magnotrans/sd2snes/README.md

sd2snes
=======

SD card based multi-purpose cartridge for the SNES
