magnotrans/sd2snes/pcb/kicad/RevF/sd2snes.kicad_pcb

## KiCad design pcb/kicad/RevF/sd2snes.kicad_pcb (2018-08-11)

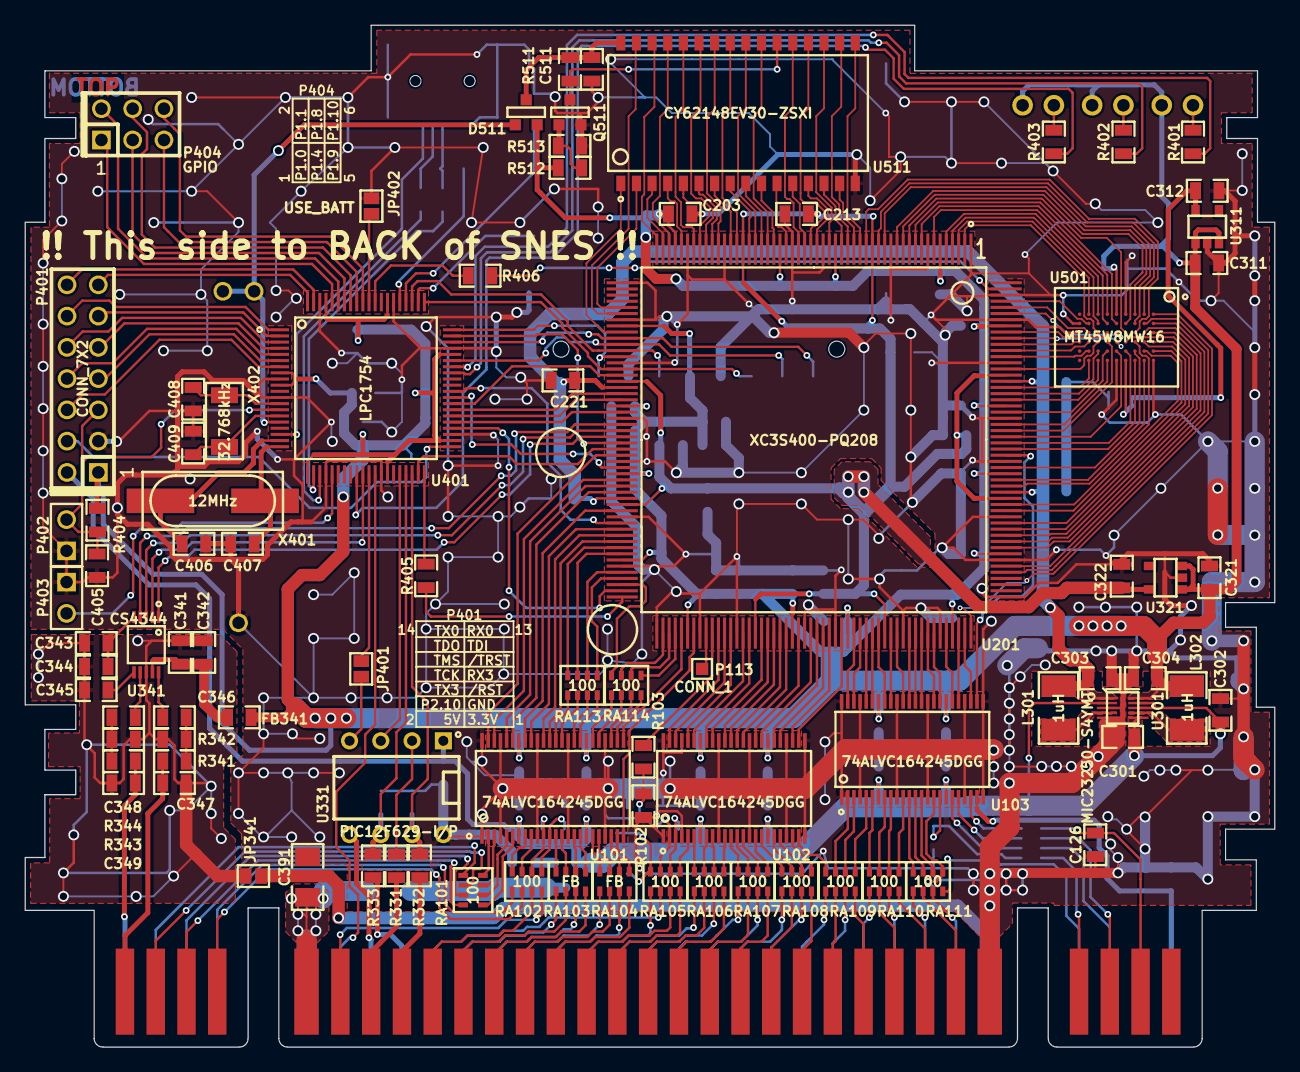
[picture p1: board sd2snes.kicad_pcb from above]

Board: 2 copper layers, 101.5 x 83.0 mm, 153 parts (0 on the bottom side), 326 nets.

Parts:
BT351: Keystone 1059 / KZH20PCB; BT_KEYSTONE_1059_20MM
C101, C102, C103, C104, C105, C106, C111, C112, C113, C114, C115, C116, C201, C202, C203, C204, C205, C206, C207, C208, C209, C210, C211, C212, C213, C214, C215, C221, C222, C223, C224, C231, C232, C233, C234, C331, C341, C343, C401, C402, C403, C404, C405, C412, C501, C502, C511: 100n; SM0805_FIXEDMASK
C121, C122, C123, C124, C125, C126, C127, C128, C408, C409: 10p; SM0805_FIXEDMASK
C301, C303, C304, C311, C312, C321, C322: 4.7u; SM0805_FIXEDMASK
C302, C347, C349: 10n; SM0805_FIXEDMASK
C332, C333: 100p; SM0805_FIXEDMASK
C342: 1u; SM0805_FIXEDMASK
C344, C345, C411: 10u; SM0805_FIXEDMASK
C346, C348: 3.3u; SM0805_FIXEDMASK
C391: 100u; SM1206_NEW
C406, C407: 33p; SM0805_FIXEDMASK
D401: LED 2mA 1.9V, green; LED-3MM-FIXED
D402: LED 2mA 1.8V, yellow; LED-3MM-FIXED
D403: LED 2mA 1.7V, red; LED-3MM-FIXED
D511: BAT54C; SOT23EBC
FB341: FILTER; SM0805_FIXEDMASK
J101: SNESCART_EXT; SNESCART_EXT2_SMTUSB
J411: Hirose DM1AA; HRS-DM1AA
J421: USB Mini-B SMT; USB_MINIB_SMT
JP341: FB 0603; GS2
JP401, JP402: JUMPER; GS2
L301, L302: 1uH; SM1210L_NEW
L391: 10uH; SM1210L_NEW
P113: CONN_1; PAD_1x1mm
P401: CONN_7X2; pin_array_7x2
P402, P403: CONN_2; PIN_ARRAY_2X1
P404: CONN_3X2; pin_array_3x2
Q101, Q511: 2N2222A; SOT23EBC
Q301: IRLML6402PbF; SOT23GDS
R101: 270; SM0805_FIXEDMASK
R102, R513: 100k; SM0805_FIXEDMASK
R103, R512: 4k7; SM0805_FIXEDMASK
R301, R511: 20k; SM0805_FIXEDMASK
R331, R332, R333, R401, R402, R403: 680; SM0805_FIXEDMASK
R341, R343: 470; SM0805_FIXEDMASK
R342, R344, R404, R407: 10k; SM0805_FIXEDMASK
R405, R406: 100; SM0805_FIXEDMASK
R421, R422: 33; SM0805_FIXEDMASK
R423: 1.5k; SM0805_FIXEDMASK
RA101, RA102, RA105, RA106, RA107, RA108, RA109, RA110, RA111, RA112, RA113, RA114: 100; R_PACK_1206_2
RA103, RA104: FB; R_PACK_1206_2
U101, U102, U103: 74ALVC164245DGG; TSSOP48
U201: XC3S400-PQ208; PQFP208
U301: MIC23250-S4YMT; QFN10-2x2_LONGPADS
U311: MCP1824-1802E/OT; SOT23-5_LARGEPADS
U321: MCP1824-2502E/OT; SOT23-5_LARGEPADS
U331: PIC12F629-I/P; DIP-8__300
U341: CS4344; TSSOP10
U401: LPC1754; LQFP80-.5
U501: MT45W8MW16; VFBGA54
U511: CY62148EV30-ZSXI; TSOPII-32
X401: 12MHz; HC49US
X402: 32.768kHz; XTAL_SMD_05019

Connections:
+1.2V: C221.1, C222.1, C223.1, C224.1, C303.1, L301.1, U201.70, U201.88, U201.174, U201.192, U301.1
+1.8V: C312.1, C502.1, U311.5, U501.D6
+2.5V: C210.1, C211.1, C212.1, C213.1, C214.1, C215.1, C322.1, U201.17, U201.38, U201.69, U201.89, U201.121, U201.142, U201.173, U201.193, U321.5
+3.3V: C101.1, C102.1, C103.1, C104.1, C105.1, C106.1, C201.1, C202.1, C203.1, C204.1, C205.1, C206.1, C207.1, C208.1, C209.1, C231.1, C232.1, C233.1, C234.1, C304.1, C311.1, C321.1, C401.1, C402.1, C403.1, C404.1, C411.1, C412.1, C501.1, D401.1, D402.1, D403.1, D511.1, FB341.1, J411.4, L302.2, P401.1, R404.2, R407.2, R512.2, U101.31, U101.42, U102.31, U102.42, U103.31, U103.42, U201.6, U201.23, U201.32, U201.49, U201.60, U201.73, U201.84, U201.98, U201.110, U201.127, U201.136, U201.153, U201.164, U201.177, U201.188, U201.201, U301.10, U311.1, U311.3, U321.1, U321.3, U401.8, U401.10, U401.21, U401.34, U401.42, U401.56, U401.67, U401.77, U501.E1
+3.3VDAC: C341.1, C342.1, FB341.2, U341.9
+5V: C111.1, C112.1, C113.1, C114.1, C115.1, C116.1, C301.1, C302.1, C331.1, P401.2, Q301.S, U101.7, U101.18, U102.7, U102.18, U103.7, U103.18, U301.2, U301.6, U301.8, U301.9, U331.1
+5VL: C391.1, J101.27, J101.58, L391.1
+BATT: BT351.1, D511.2, U401.16
/Memory/RAM_/CE: Q511.3, R511.2, U511.22
/Memory/SRAM_Vcc: C511.1, D511.3, R511.1, U511.32
/Power Supply / Misc./REG_SW1: L301.2, U301.4
/Power Supply / Misc./REG_SW2: L302.1, U301.7
/RESET: C405.1, P401.5, P402.2, R404.1, U401.14
/SNES Slot/SNES_EXT_/IRQ: J101.18, RA105.1
/SNES Slot/SNES_EXT_/PARD: J101.4, RA111.4
/SNES Slot/SNES_EXT_/PAWR: J101.35, RA112.8
/SNES Slot/SNES_EXT_/RD: J101.23, RA105.2
/SNES Slot/SNES_EXT_/ROMSEL: J101.49, RA105.3
/SNES Slot/SNES_EXT_/WR: J101.54, RA102.3
/SNES Slot/SNES_EXT_A0: J101.17, RA106.1
/SNES Slot/SNES_EXT_A1: J101.16, RA106.3
/SNES Slot/SNES_EXT_A2: J101.15, RA107.1
/SNES Slot/SNES_EXT_A3: J101.14, RA107.3
/SNES Slot/SNES_EXT_A4: J101.13, RA108.1
/SNES Slot/SNES_EXT_A5: J101.12, RA108.3
/SNES Slot/SNES_EXT_A6: J101.11, RA109.1
/SNES Slot/SNES_EXT_A7: J101.10, RA109.3
/SNES Slot/SNES_EXT_A8: J101.9, RA110.1
/SNES Slot/SNES_EXT_A9: J101.8, RA110.3
/SNES Slot/SNES_EXT_A10: J101.7, RA111.1
/SNES Slot/SNES_EXT_A11: J101.6, RA111.3
/SNES Slot/SNES_EXT_A12: J101.37, RA111.2
/SNES Slot/SNES_EXT_A13: J101.38, RA110.4
/SNES Slot/SNES_EXT_A14: J101.39, RA110.2
/SNES Slot/SNES_EXT_A15: J101.40, RA109.4
/SNES Slot/SNES_EXT_A16: J101.41, RA109.2
/SNES Slot/SNES_EXT_A17: J101.42, RA108.4
/SNES Slot/SNES_EXT_A18: J101.43, RA108.2
/SNES Slot/SNES_EXT_A19: J101.44, RA107.4
/SNES Slot/SNES_EXT_A20: J101.45, RA107.2
/SNES Slot/SNES_EXT_A21: J101.46, RA106.4
/SNES Slot/SNES_EXT_A22: J101.47, RA106.2
/SNES Slot/SNES_EXT_A23: J101.48, RA105.4
/SNES Slot/SNES_EXT_CPU_CLK: J101.57, RA102.4
/SNES Slot/SNES_EXT_D0: J101.19, RA104.3
/SNES Slot/SNES_EXT_D1: J101.20, RA104.1
/SNES Slot/SNES_EXT_D2: J101.21, RA103.3
/SNES Slot/SNES_EXT_D3: J101.22, RA103.1
/SNES Slot/SNES_EXT_D4: J101.50, RA104.4
/SNES Slot/SNES_EXT_D5: J101.51, RA104.2
/SNES Slot/SNES_EXT_D6: J101.52, RA103.4
/SNES Slot/SNES_EXT_D7: J101.53, RA103.2
/SNES Slot/SNES_EXT_PA0: J101.28, RA102.1
/SNES Slot/SNES_EXT_PA1: J101.59, RA102.2
/SNES Slot/SNES_EXT_PA2: J101.29, RA101.3
/SNES Slot/SNES_EXT_PA3: J101.60, RA101.4
/SNES Slot/SNES_EXT_PA4: J101.30, RA101.1
/SNES Slot/SNES_EXT_PA5: J101.61, RA101.2
/SNES Slot/SNES_EXT_PA6: J101.3, RA112.7
/SNES Slot/SNES_EXT_PA7: J101.34, RA112.6
/SNES Slot/SNES_EXT_REFRESH: C126.1, J101.33, RA112.5
/SNES Slot/SNES_EXT_SYS_CLK: J101.1, R101.2, U103.23
/TRST: P401.9, U401.4
/USEBATT: JP402.2, U401.70
AGND: C341.2, C342.2, C343.2, C344.2, C345.2, C347.2, C349.2, JP341.2, R342.2, R344.2, U341.8
AUDIO_L: C349.1, J101.31, R343.1
AUDIO_R: C347.1, J101.62, R341.1
CCLK: R405.1, U201.104
CIC_CLK: J101.56, R331.2
CIC_DATA0: C332.1, R332.1, U331.7, U401.38
CIC_DATA1: C333.1, R333.2, U331.6, U401.37
CIC_MCLR: JP401.2, U331.4
CIC_RESET: J101.25, U331.5
CIC_STATUS: U331.3, U401.36
DAC_/DEM: U341.2, U401.30
DAC_LRCK: U201.77, U341.3
DAC_MCLK: U201.76, U341.4
DAC_SDIN: U201.78, U341.1
DATABUS_/OE: U101.25, U201.109
DATABUS_DIR: U101.24, U201.111
DIN+MCU_/OVR: U201.92, U401.50
DONE: U201.103, U401.44
EXT_CIC_DATA0: J101.55, R332.2
EXT_CIC_DATA1: J101.24, R333.1
EXT_TDI: P401.11, U401.2
EXT_TDO: P401.12, U401.1
FPGA_CLK: U201.80, U401.39
GND: BT351.2, C101.2, C102.2, C103.2, C104.2, C105.2, C106.2, C111.2, C112.2, C113.2, C114.2, C115.2, C116.2, C121.2, C122.2, C123.2, C124.2, C125.2, C126.2, C127.2, C128.2, C201.2, C202.2, C203.2, C204.2, C205.2, C206.2, C207.2, C208.2, C209.2, C210.2, C211.2, C212.2, C213.2, C214.2, C215.2, C221.2, C222.2, C223.2, C224.2, C231.2, C232.2, C233.2, C234.2, C301.2, C302.2, C303.2, C304.2, C311.2, C312.2, C321.2, C322.2, C331.2, C332.2, C333.2, C391.2, C401.2, C402.2, C403.2, C404.2, C405.2, C406.2, C407.2, C408.2, C409.2, C411.2, C412.2, C501.2, C502.2, C511.2, J101.5, J101.36, J411.3, J411.6, J411.GND1, J411.GND2, J421.5, J421.6, J421.7, JP341.1, JP402.1, P401.3, P402.1, P403.1, Q101.1, Q511.1, R101.1, R102.2, R301.1, R513.2, U101.1, U101.4, U101.10, U101.15, U101.21, U101.28, U101.34, U101.39, U101.45, U101.48, U102.1, U102.4, U102.10, U102.15, U102.21, U102.24, U102.25, U102.28, U102.34, U102.39, U102.45, U102.48, U103.1, U103.4, U103.10, U103.15, U103.21, U103.24, U103.25, U103.28, U103.34, U103.39, U103.45, U103.48, U201.1, U201.8, U201.14, U201.25, U201.30, U201.41, U201.47, U201.53, U201.59, U201.66, U201.75, U201.82, U201.91, U201.99, U201.105, U201.112, U201.118, U201.129, U201.134, U201.145, U201.151, U201.157, U201.163, U201.170, U201.179, U201.186, U201.195, U201.202, U201.206, U301.3, U301.5, U311.2, U321.2, U331.8, U401.9, U401.12, U401.24, U401.33, U401.43, U401.57, U401.66, U401.78, U501.A6, U501.D1, U501.E6, U501.J2, U501.J3, U511.16
INIT_B+MCU_IRQ: U201.83, U401.49
MCU_SPARE: P404.4, U401.73
MCU_SPI_MISO: U201.72, U401.46
MCU_SPI_MOSI: U201.74, U401.45
MCU_SPI_SCK: U201.71, U401.47
MCU_SPI_SS: U201.68, U401.48
unnamed: C125.1, RA105.7, U102.2
unnamed: C124.1, RA102.6, U101.11
unnamed: Q101.2, R102.1, R103.2
unnamed: RA108.5, U102.22
unnamed: RA105.5, U102.5
unnamed: RA106.8, U102.6
unnamed: RA106.7, U102.8
unnamed: RA106.6, U102.9
unnamed: RA108.6, U102.20
unnamed: RA106.5, U102.11
unnamed: RA107.8, U102.12
unnamed: RA107.7, U102.13
unnamed: RA109.8, U102.23
unnamed: RA107.6, U102.14
unnamed: RA107.5, U102.16
unnamed: RA103.6, U101.16
unnamed: RA104.6, U101.22
unnamed: RA113.4, U101.32
unnamed: RA103.8, U101.13
unnamed: RA104.5, U101.23
unnamed: RA113.3, U101.33
unnamed: RA103.7, U101.14
unnamed: RA113.2, U101.35
unnamed: RA114.4, U101.26
unnamed: RA113.1, U101.36
unnamed: RA103.5, U101.17
unnamed: RA114.3, U101.27
unnamed: RA104.8, U101.19
unnamed: RA101.7, U101.3
unnamed: RA108.8, U102.17
unnamed: RA108.7, U102.19
unnamed: RA101.8, U101.2
unnamed: RA101.6, U101.5
unnamed: RA101.5, U101.6
unnamed: RA102.8, U101.8
unnamed: RA102.7, U101.9
unnamed: RA104.7, U101.20
unnamed: RA114.1, U101.30
unnamed: RA109.6, U103.3
unnamed: RA109.7, U103.2
unnamed: RA109.5, U103.5
unnamed: RA110.8, U103.6
unnamed: C122.1, RA105.6, U102.3
unnamed: C121.1, RA102.5, U101.12
unnamed: RA110.7, U103.8
unnamed: RA114.2, U101.29
unnamed: RA111.8, U103.12
unnamed: C123.1, Q101.3, RA105.8
unnamed: C127.1, RA112.1, U103.17
unnamed: RA112.2, U103.19
unnamed: RA112.3, U103.20
unnamed: RA112.4, U103.22
unnamed: C128.1, RA111.5, U103.16
unnamed: RA111.6, U103.14
unnamed: RA111.7, U103.13
unnamed: RA110.5, U103.11
unnamed: RA110.6, U103.9
unnamed: P113.1, U201.113
unnamed: L391.2, Q301.D
unnamed: Q301.G, R301.2
unnamed: R331.1, U331.2
unnamed: C346.2, U341.10
unnamed: C343.1, C344.1, U341.5
unnamed: C345.1, U341.6
unnamed: C348.2, U341.7
unnamed: C348.1, R343.2, R344.1
unnamed: C346.1, R341.2, R342.1
unnamed: J411.WP, U401.64
unnamed: R401.1, U401.54
unnamed: JP401.1, U401.31
unnamed: D402.2, R402.2
unnamed: R421.2, U401.22
unnamed: J421.2, R422.1
unnamed: D403.2, R403.2
unnamed: P403.2, U401.25
unnamed: R422.2, U401.23
unnamed: J421.3, R421.1, R423.1
unnamed: D401.2, R401.2
unnamed: J411.DT, U401.62
unnamed: R402.1, U401.53
unnamed: R403.1, U401.29
unnamed: R406.1, U401.69
unnamed: R405.2, U401.40
unnamed: J421.1, U401.18
unnamed: C408.1, U401.13, X402.1
unnamed: C409.1, U401.15, X402.2
unnamed: C406.1, U401.19, X401.1
unnamed: C407.1, U401.20, X401.2
unnamed: Q511.2, R512.1, R513.1
P1_CLK: P404.2, U401.75
P1_D0: P404.1, U401.76
P2.10: P401.4, R407.1, U401.41
P2_CLK: P404.5, U401.72
P2_D0: P404.6, U401.71
PROG_B: R406.2, U201.207
P_LATCH: P404.3, U401.74
RAM_/OE: U201.36, U511.24
RAM_/WE: U201.50, U511.29
RAM_A0: U201.28, U511.12
RAM_A1: U201.31, U511.11
RAM_A2: U201.33, U511.10
RAM_A3: U201.35, U511.9
RAM_A4: U201.37, U511.8
RAM_A5: U201.40, U511.7
RAM_A6: U201.43, U511.6
RAM_A7: U201.45, U511.5
RAM_A8: U201.44, U511.27
RAM_A9: U201.42, U511.26
RAM_A10: U201.34, U511.23
RAM_A11: U201.39, U511.25
RAM_A12: U201.48, U511.4
RAM_A13: U201.46, U511.28
RAM_A14: U201.51, U511.3
RAM_A15: U201.58, U511.31
RAM_A16: U201.57, U511.2
RAM_A17: U201.61, U511.1
RAM_A18: U201.52, U511.30
RAM_DQ0: U201.26, U511.13
RAM_DQ1: U201.22, U511.14
RAM_DQ2: U201.20, U511.15
RAM_DQ3: U201.19, U511.17
RAM_DQ4: U201.21, U511.18
RAM_DQ5: U201.24, U511.19
RAM_DQ6: U201.27, U511.20
RAM_DQ7: U201.29, U511.21
ROM_/CE: U201.172, U501.B5
ROM_/LB: U201.156, U501.A1
ROM_/OE: U201.162, U501.A2
ROM_/UB: U201.161, U501.B2
ROM_/WE: U201.190, U501.G5
ROM_A0: U201.166, U501.A3
ROM_A1: U201.168, U501.A4
ROM_A2: U201.171, U501.A5
ROM_A3: U201.165, U501.B3
ROM_A4: U201.169, U501.B4
ROM_A5: U201.18, U501.C3
ROM_A6: U201.175, U501.C4
ROM_A7: U201.167, U501.D4
ROM_A8: U201.205, U501.H2
ROM_A9: U201.204, U501.H3
ROM_A10: U201.197, U501.H4
ROM_A11: U201.196, U501.H5
ROM_A12: U201.2, U501.G3
ROM_A13: U201.194, U501.G4
ROM_A14: U201.200, U501.F3
ROM_A15: U201.184, U501.F4
ROM_A16: U201.199, U501.E4
ROM_A17: U201.11, U501.D3
ROM_A18: U201.3, U501.H1
ROM_A19: U201.4, U501.G2
ROM_A20: U201.191, U501.H6
ROM_A21: U201.203, U501.E3
ROM_A22: U201.198, U501.J4
ROM_DQ0: U201.176, U501.B6
ROM_DQ1: U201.178, U501.C5
ROM_DQ2: U201.181, U501.C6
ROM_DQ3: U201.182, U501.D5
ROM_DQ4: U201.183, U501.E5
ROM_DQ5: U201.187, U501.F5
ROM_DQ6: U201.185, U501.F6
ROM_DQ7: U201.189, U501.G6
ROM_DQ8: U201.16, U501.B1
ROM_DQ9: U201.13, U501.C1
ROM_DQ10: U201.15, U501.C2
ROM_DQ11: U201.12, U501.D2
ROM_DQ12: U201.10, U501.E2
ROM_DQ13: U201.7, U501.F2
ROM_DQ14: U201.9, U501.F1
ROM_DQ15: U201.5, U501.G1
RX0: P401.13, U401.80
RX3: P401.7, U401.6
SD_CLK: J411.5, U201.64, U401.63
SD_CMD: J411.2, U201.67, U401.61
SD_DAT0: J411.7, U201.65, U401.60
SD_DAT1: J411.8, U201.79, U401.59
SD_DAT2: J411.9, U201.62, U401.58
SD_DAT3: J411.1, U201.63, U401.55
SNES_/PARD: U103.33, U201.149
SNES_/PAWR: U103.32, U201.150
SNES_/RD: U102.47, U201.115
SNES_/RESET: J101.26, U401.32
SNES_/ROMSEL: U102.46, U201.116
SNES_/WR: U101.38, U201.94
SNES_A0: U102.43, U201.119
SNES_A1: U102.40, U201.122
SNES_A2: U102.37, U201.124
SNES_A3: U102.35, U201.126
SNES_A4: U102.32, U201.130
SNES_A5: U102.29, U201.132
SNES_A6: U102.26, U201.135
SNES_A7: U103.46, U201.138
SNES_A8: U103.43, U201.140
SNES_A9: U103.40, U201.143
SNES_A10: U103.37, U201.146
SNES_A11: U103.35, U201.148
SNES_A12: U103.36, U201.147
SNES_A13: U103.38, U201.144
SNES_A14: U103.41, U201.141
SNES_A15: U103.44, U201.139
SNES_A16: U103.47, U201.137
SNES_A17: U102.27, U201.133
SNES_A18: U102.30, U201.131
SNES_A19: U102.33, U201.128
SNES_A20: U102.36, U201.125
SNES_A21: U102.38, U201.123
SNES_A22: U102.41, U201.120
SNES_A23: U102.44, U201.117
SNES_CPU_CLK: U101.37, U201.95
SNES_D0: RA114.6, U201.107
SNES_D1: RA114.8, U201.102
SNES_D2: RA113.6, U201.100
SNES_D3: RA113.8, U201.96
SNES_D4: RA114.5, U201.108
SNES_D5: RA114.7, U201.106
SNES_D6: RA113.5, U201.101
SNES_D7: RA113.7, U201.97
SNES_IRQ_EN: R103.1, U201.114
SNES_PA0: U101.41, U201.90
SNES_PA1: U101.40, U201.93
SNES_PA2: U101.44, U201.86
SNES_PA3: U101.43, U201.87
SNES_PA4: U101.47, U201.81
SNES_PA5: U101.46, U201.85
SNES_PA6: U103.30, U201.152
SNES_PA7: U103.29, U201.154
SNES_REFRESH: U103.27, U201.155
SNES_SYS_CLK: U103.26, U201.180
TCK: P401.8, U401.5
TMS: P401.10, U401.3
TX0: P401.14, U401.79
TX3: P401.6, U401.7
USB_SWCONN: R423.2, U401.65
