magnotrans/sd2snes/verilog/sd2snes_cx4/main.ucf

NET "CLKIN" TNM_NET = "CLKIN";
TIMESPEC TS_CLKIN = PERIOD "CLKIN" 24.01 MHz HIGH 50 %;
//TIMESPEC TS_CLKIN = PERIOD "CLKIN" 21.5 MHz HIGH 50 %;
NET "p113_out" IOSTANDARD = LVCMOS33;
NET "p113_out" LOC = P113;

NET "SNES_SYSCLK" TNM_NET = "SNES_SYSCLK";
TIMESPEC TS_SNES_SYSCLK = PERIOD "SNES_SYSCLK" 21.5 MHz HIGH 50 %;

NET "SPI_SCK" LOC = P71;
NET "SPI_SCK" CLOCK_DEDICATED_ROUTE = FALSE;
NET "SPI_SCK" TNM_NET = "SPI_SCK";
TIMESPEC TS_SPI_SCK = PERIOD "SPI_SCK" 48.1 MHz HIGH 50 %;

NET "SPI_SCK" IOSTANDARD = LVCMOS33;
NET "SPI_SCK" DRIVE = 8;
NET "SPI_SCK" PULLUP;

NET "SNES_ROMSEL_IN" IOSTANDARD = LVCMOS33;
NET "SNES_READ_IN" IOSTANDARD = LVCMOS33;
NET "SNES_WRITE_IN" IOSTANDARD = LVCMOS33;
NET "SNES_CPU_CLK_IN" IOSTANDARD = LVCMOS33;
NET "SNES_REFRESH" IOSTANDARD = LVCMOS33;

NET "CLKIN" IOSTANDARD = LVCMOS33;
//NET "CLKIN" PULLUP;
NET "SPI_SS" PULLUP;
//NET "DCM_RST" LOC = P46;
//NET "DCM_RST" IOSTANDARD = LVCMOS33;
NET "SNES_DATABUS_DIR" IOSTANDARD = LVCMOS33;
NET "SNES_DATABUS_OE" IOSTANDARD = LVCMOS33;
NET "SNES_IRQ" IOSTANDARD = LVCMOS33;

NET "ROM_CE" LOC = P172;
NET "ROM_CE" IOSTANDARD = LVCMOS33;
NET "ROM_CE" DRIVE = 8;

NET "SNES_ADDR_IN[0]" LOC = P119;
NET "SNES_ADDR_IN[10]" LOC = P146;
NET "SNES_ADDR_IN[11]" LOC = P148;
NET "SNES_ADDR_IN[12]" LOC = P147;
NET "SNES_ADDR_IN[13]" LOC = P144;
NET "SNES_ADDR_IN[14]" LOC = P141;
NET "SNES_ADDR_IN[15]" LOC = P139;
NET "SNES_ADDR_IN[16]" LOC = P137;
NET "SNES_ADDR_IN[17]" LOC = P133;
NET "SNES_ADDR_IN[18]" LOC = P131;
NET "SNES_ADDR_IN[19]" LOC = P128;
NET "SNES_ADDR_IN[1]" LOC = P122;
NET "SNES_ADDR_IN[20]" LOC = P125;
NET "SNES_ADDR_IN[21]" LOC = P123;
NET "SNES_ADDR_IN[22]" LOC = P120;
NET "SNES_ADDR_IN[23]" LOC = P117;
NET "SNES_ADDR_IN[2]" LOC = P124;
NET "SNES_ADDR_IN[3]" LOC = P126;
NET "SNES_ADDR_IN[4]" LOC = P130;
NET "SNES_ADDR_IN[5]" LOC = P132;
NET "SNES_ADDR_IN[6]" LOC = P135;
NET "SNES_ADDR_IN[7]" LOC = P138;
NET "SNES_ADDR_IN[8]" LOC = P140;
NET "SNES_ADDR_IN[9]" LOC = P143;
NET "SNES_DATA[0]" LOC = P107;
NET "SNES_DATA[1]" LOC = P102;
NET "SNES_DATA[2]" LOC = P100;
NET "SNES_DATA[3]" LOC = P96;
NET "SNES_DATA[4]" LOC = P108;
NET "SNES_DATA[5]" LOC = P106;
NET "SNES_DATA[6]" LOC = P101;
NET "SNES_DATA[7]" LOC = P97;


NET "CLKIN" LOC = P80;
// NET "RST" LOC = P113;
NET "MCU_OVR" LOC = P92;


NET "MCU_OVR" IOSTANDARD = LVCMOS33;
NET "MCU_OVR" DRIVE = 8;

NET "MCU_RDY" LOC = P83;
NET "MCU_RDY" IOSTANDARD = LVCMOS33;
NET "MCU_RDY" DRIVE = 8;


NET "ROM_ADDR[0]" LOC = P166;


NET "ROM_ADDR[0]" IOSTANDARD = LVCMOS33;
NET "ROM_ADDR[0]" DRIVE = 8;


NET "ROM_ADDR[10]" LOC = P197;


NET "ROM_ADDR[10]" IOSTANDARD = LVCMOS33;
NET "ROM_ADDR[10]" DRIVE = 8;


NET "ROM_ADDR[11]" LOC = P196;


NET "ROM_ADDR[11]" IOSTANDARD = LVCMOS33;
NET "ROM_ADDR[11]" DRIVE = 8;


NET "ROM_ADDR[12]" LOC = P2;


NET "ROM_ADDR[12]" IOSTANDARD = LVCMOS33;
NET "ROM_ADDR[12]" DRIVE = 8;


NET "ROM_ADDR[13]" LOC = P194;


NET "ROM_ADDR[13]" IOSTANDARD = LVCMOS33;
NET "ROM_ADDR[13]" DRIVE = 8;


NET "ROM_ADDR[14]" LOC = P200;


NET "ROM_ADDR[14]" IOSTANDARD = LVCMOS33;
NET "ROM_ADDR[14]" DRIVE = 8;


NET "ROM_ADDR[15]" LOC = P184;


NET "ROM_ADDR[15]" IOSTANDARD = LVCMOS33;
NET "ROM_ADDR[15]" DRIVE = 8;


NET "ROM_ADDR[16]" LOC = P199;


NET "ROM_ADDR[16]" IOSTANDARD = LVCMOS33;
NET "ROM_ADDR[16]" DRIVE = 8;


NET "ROM_ADDR[17]" LOC = P11;


NET "ROM_ADDR[17]" IOSTANDARD = LVCMOS33;
NET "ROM_ADDR[17]" DRIVE = 8;


NET "ROM_ADDR[18]" LOC = P3;


NET "ROM_ADDR[18]" IOSTANDARD = LVCMOS33;
NET "ROM_ADDR[18]" DRIVE = 8;


NET "ROM_ADDR[19]" LOC = P4;


NET "ROM_ADDR[19]" IOSTANDARD = LVCMOS33;
NET "ROM_ADDR[19]" DRIVE = 8;


NET "ROM_ADDR[1]" LOC = P168;


NET "ROM_ADDR[1]" IOSTANDARD = LVCMOS33;
NET "ROM_ADDR[1]" DRIVE = 8;


NET "ROM_ADDR[20]" LOC = P191;


NET "ROM_ADDR[20]" IOSTANDARD = LVCMOS33;
NET "ROM_ADDR[20]" DRIVE = 8;


NET "ROM_ADDR[21]" LOC = P203;


NET "ROM_ADDR[21]" IOSTANDARD = LVCMOS33;
NET "ROM_ADDR[21]" DRIVE = 8;


NET "ROM_ADDR[22]" LOC = P198;


NET "ROM_ADDR[22]" IOSTANDARD = LVCMOS33;
NET "ROM_ADDR[22]" DRIVE = 8;


NET "ROM_ADDR[2]" LOC = P171;


NET "ROM_ADDR[2]" IOSTANDARD = LVCMOS33;
NET "ROM_ADDR[2]" DRIVE = 8;


NET "ROM_ADDR[3]" LOC = P165;


NET "ROM_ADDR[3]" IOSTANDARD = LVCMOS33;
NET "ROM_ADDR[3]" DRIVE = 8;


NET "ROM_ADDR[4]" LOC = P169;


NET "ROM_ADDR[4]" IOSTANDARD = LVCMOS33;
NET "ROM_ADDR[4]" DRIVE = 8;


NET "ROM_ADDR[5]" LOC = P18;


NET "ROM_ADDR[5]" IOSTANDARD = LVCMOS33;
NET "ROM_ADDR[5]" DRIVE = 8;


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
NET "SNES_ADDR_IN[6]" DRIVE = 8;
NET "SNES_ADDR_IN[7]" IOSTANDARD = LVCMOS33;
NET "SNES_ADDR_IN[7]" DRIVE = 8;
NET "SNES_ADDR_IN[8]" IOSTANDARD = LVCMOS33;
NET "SNES_ADDR_IN[8]" DRIVE = 8;
NET "SNES_ADDR_IN[9]" IOSTANDARD = LVCMOS33;
NET "SNES_ADDR_IN[9]" DRIVE = 8;


NET "SNES_CPU_CLK_IN" LOC = P95;
NET "SNES_ROMSEL_IN" LOC = P116;
NET "SNES_DATABUS_DIR" LOC = P111;
NET "SNES_DATABUS_OE" LOC = P109;
NET "SNES_DATABUS_DIR" DRIVE = 8;
NET "SNES_DATABUS_OE" DRIVE = 8;


NET "SNES_DATA[0]" IOSTANDARD = LVCMOS33;
NET "SNES_DATA[0]" DRIVE = 8;
NET "SNES_DATA[1]" IOSTANDARD = LVCMOS33;
NET "SNES_DATA[1]" DRIVE = 8;
NET "SNES_DATA[2]" IOSTANDARD = LVCMOS33;
NET "SNES_DATA[2]" DRIVE = 8;
NET "SNES_DATA[3]" IOSTANDARD = LVCMOS33;
NET "SNES_DATA[3]" DRIVE = 8;
NET "SNES_DATA[4]" IOSTANDARD = LVCMOS33;
NET "SNES_DATA[4]" DRIVE = 8;
NET "SNES_DATA[5]" IOSTANDARD = LVCMOS33;
NET "SNES_DATA[5]" DRIVE = 8;
NET "SNES_DATA[6]" IOSTANDARD = LVCMOS33;
NET "SNES_DATA[6]" DRIVE = 8;
NET "SNES_DATA[7]" IOSTANDARD = LVCMOS33;
NET "SNES_DATA[7]" DRIVE = 8;


NET "SNES_IRQ" LOC = P114;
NET "SNES_READ_IN" LOC = P115;
NET "SNES_REFRESH" LOC = P155;
NET "SNES_WRITE_IN" LOC = P94;

NET "SNES_PA_IN[0]" IOSTANDARD = LVCMOS33;
NET "SNES_PA_IN[0]" LOC = P90;
NET "SNES_PA_IN[1]" IOSTANDARD = LVCMOS33;
NET "SNES_PA_IN[1]" LOC = P93;
NET "SNES_PA_IN[2]" IOSTANDARD = LVCMOS33;
NET "SNES_PA_IN[2]" LOC = P86;
NET "SNES_PA_IN[3]" IOSTANDARD = LVCMOS33;
NET "SNES_PA_IN[3]" LOC = P87;
NET "SNES_PA_IN[4]" IOSTANDARD = LVCMOS33;
NET "SNES_PA_IN[4]" LOC = P81;
NET "SNES_PA_IN[5]" IOSTANDARD = LVCMOS33;
NET "SNES_PA_IN[5]" LOC = P85;
NET "SNES_PA_IN[6]" IOSTANDARD = LVCMOS33;
NET "SNES_PA_IN[6]" LOC = P152;
NET "SNES_PA_IN[7]" IOSTANDARD = LVCMOS33;
NET "SNES_PA_IN[7]" LOC = P154;

NET "SNES_PARD_IN" IOSTANDARD = LVCMOS33;
NET "SNES_PARD_IN" LOC = P149;
NET "SNES_PAWR_IN" IOSTANDARD = LVCMOS33;
NET "SNES_PAWR_IN" LOC = P150;

NET "SPI_MISO" LOC = P72;


NET "SPI_MISO" IOSTANDARD = LVCMOS33;
NET "SPI_MISO" DRIVE = 8;


NET "SPI_MOSI" LOC = P74;


NET "SPI_MOSI" IOSTANDARD = LVCMOS33;
NET "SPI_MOSI" DRIVE = 8;


NET "SPI_SS" LOC = P68;


NET "SPI_SS" IOSTANDARD = LVCMOS33;
NET "SPI_SS" DRIVE = 8;


NET "DAC_LRCK" LOC = P77;


NET "DAC_LRCK" IOSTANDARD = LVCMOS33;
NET "DAC_LRCK" DRIVE = 8;


NET "DAC_MCLK" LOC = P76;


NET "DAC_MCLK" IOSTANDARD = LVCMOS33;
NET "DAC_MCLK" DRIVE = 8;


NET "DAC_SDOUT" LOC = P78;


NET "DAC_SDOUT" IOSTANDARD = LVCMOS33;
NET "DAC_SDOUT" DRIVE = 8;

# PlanAhead Generated physical constraints 
NET "SD_CLK" LOC = P64;
NET "SD_CMD" LOC = P67;
NET "SD_DAT[0]" LOC = P65;
NET "SD_DAT[1]" LOC = P79;
NET "SD_DAT[2]" LOC = P62;
NET "SD_DAT[3]" LOC = P63;

# PlanAhead Generated IO constraints 
NET "SD_CLK" IOSTANDARD = LVCMOS33;
NET "SD_CLK" PULLUP;
NET "SD_CMD" IOSTANDARD = LVCMOS33;
NET "SD_DAT[0]" IOSTANDARD = LVCMOS33;
NET "SD_DAT[1]" IOSTANDARD = LVCMOS33;
NET "SD_DAT[2]" IOSTANDARD = LVCMOS33;
NET "SD_DAT[3]" IOSTANDARD = LVCMOS33;

NET "SNES_SYSCLK" LOC = P180;
NET "SNES_SYSCLK" IOSTANDARD = LVCMOS33;

TIMEGRP "DAC" = FFS("snes_dac/dac_address_r<0>") FFS("snes_dac/dac_address_r<1>") FFS("snes_dac/dac_address_r<2>") FFS("snes_dac/dac_address_r<3>") FFS("snes_dac/dac_address_r<4>") FFS("snes_dac/dac_address_r<5>") FFS("snes_dac/dac_address_r<6>") FFS("snes_dac/dac_address_r<7>") FFS("snes_dac/dac_address_r<8>") FFS("snes_dac/lrck_sreg<1>") FFS("snes_dac/lrck_sreg<2>") FFS("snes_dac/Mshreg_lrck_sreg_1") FFS("snes_dac/Mshreg_sclk_sreg_1") FFS("snes_dac/play_r") FFS("snes_dac/reset_sreg<0>") FFS("snes_dac/reset_sreg<1>") FFS("snes_dac/samples<0>") FFS("snes_dac/samples<1>") FFS("snes_dac/sclk_sreg<1>") FFS("snes_dac/sclk_sreg<2>") FFS("snes_dac/sdout_reg") FFS("snes_dac/smpshift<0>") FFS("snes_dac/smpshift<1>") FFS("snes_dac/smpshift<2>") FFS("snes_dac/smpshift<3>") FFS("snes_dac/smpshift<4>") FFS("snes_dac/smpshift<5>") FFS("snes_dac/smpshift<6>") FFS("snes_dac/smpshift<7>") FFS("snes_dac/smpshift<8>") FFS("snes_dac/smpshift<9>") FFS("snes_dac/smpshift<10>") FFS("snes_dac/smpshift<11>") FFS("snes_dac/smpshift<12>") FFS("snes_dac/smpshift<13>") FFS("snes_dac/smpshift<14>") FFS("snes_dac/smpshift_15_BRB0") FFS("snes_dac/smpshift_15_BRB1") FFS("snes_dac/smpshift_15_BRB2") FFS("snes_dac/sysclk_sreg<0>") FFS("snes_dac/sysclk_sreg<1>") FFS("snes_dac/sysclk_sreg<2>") FFS("snes_dac/vol_latch_reg<0>") FFS("snes_dac/vol_latch_reg<1>") FFS("snes_dac/vol_reg<0>") FFS("snes_dac/vol_reg<1>") FFS("snes_dac/vol_reg<2>") FFS("snes_dac/vol_reg<3>") FFS("snes_dac/vol_reg<4>") FFS("snes_dac/vol_reg<5>") FFS("snes_dac/vol_reg<6>") FFS("snes_dac/vol_reg<7>") FFS("snes_dac/vol_target_reg<0>") FFS("snes_dac/vol_target_reg<1>") FFS("snes_dac/vol_target_reg<2>") FFS("snes_dac/vol_target_reg<3>") FFS("snes_dac/vol_target_reg<4>") FFS("snes_dac/vol_target_reg<5>") FFS("snes_dac/vol_target_reg<6>") FFS("snes_dac/vol_target_reg<7>") FFS("snes_dac/vol_valid") FFS("snes_mcu_cmd/DAC_ADDR_OUT_BUF<0>") FFS("snes_mcu_cmd/DAC_ADDR_OUT_BUF<1>") FFS("snes_mcu_cmd/DAC_ADDR_OUT_BUF<2>") FFS("snes_mcu_cmd/DAC_ADDR_OUT_BUF<3>") FFS("snes_mcu_cmd/DAC_ADDR_OUT_BUF<4>") FFS("snes_mcu_cmd/DAC_ADDR_OUT_BUF<5>") FFS("snes_mcu_cmd/DAC_ADDR_OUT_BUF<6>") FFS("snes_mcu_cmd/DAC_ADDR_OUT_BUF<7>") FFS("snes_mcu_cmd/DAC_ADDR_OUT_BUF<8>") FFS("snes_mcu_cmd/DAC_ADDR_OUT_BUF<9>") FFS("snes_mcu_cmd/DAC_ADDR_OUT_BUF<10>") FFS("snes_mcu_cmd/DAC_PLAY_OUT_BUF") FFS("snes_mcu_cmd/DAC_RESET_OUT_BUF") FFS("snes_mcu_cmd/DAC_STATUSr");
TIMESPEC TS_DAC = FROM "FFS" TO "DAC" TS_CLK21 / 4;
TIMESPEC TS_DAC2 = FROM "RAMS" TO "DAC" TS_CLK21 / 4;
