magnotrans/sd2snes/verilog/sd2snes_sdd1/ipcore_dir/SDD1_Scope_Ctrl.v

///////////////////////////////////////////////////////////////////////////////
// Copyright (c) 2018 Xilinx, Inc.
// All Rights Reserved
///////////////////////////////////////////////////////////////////////////////
//   ____  ____
//  /   /\/   /
// /___/  \  /    Vendor     : Xilinx
// \   \   \/     Version    : 14.7
//  \   \         Application: Xilinx CORE Generator
//  /   /         Filename   : SDD1_Scope_Ctrl.v
// /___/   /\     Timestamp  : Fri Sep 14 23:35:00 Hora de verano romance 2018
// \   \  /  \
//  \___\/\___\
//
// Design Name: Verilog Synthesis Wrapper
///////////////////////////////////////////////////////////////////////////////
// This wrapper is used to integrate with Project Navigator and PlanAhead

`timescale 1ns/1ps

module SDD1_Scope_Ctrl(
    CONTROL0) /* synthesis syn_black_box syn_noprune=1 */;


inout [35 : 0] CONTROL0;

endmodule
