magnotrans/sd2snes/src/cli.c

/* tapplay - TAP file playback for sd2iec hardware
   Copyright (C) 2009  Ingo Korb <ingo@akana.de>

   Inspiration and low-level SD/MMC access based on code from MMC2IEC
     by Lars Pontoppidan et al., see sdcard.c|h and config.h.

   FAT filesystem access based on code from ChaN and Jim Brain, see ff.c|h.

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

   cli.c: The command line interface

*/

#include <arm/NXP/LPC17xx/LPC17xx.h>
#include <arm/bits.h>
#include <stdio.h>
#include <stdlib.h>
#include <string.h>
#include <ctype.h>
#include <errno.h>
#include <string.h>
#include <stdint.h>
#include <stdlib.h>
#include "config.h"
#include "diskio.h"
#include "ff.h"
#include "timer.h"
#include "uart.h"
#include "fileops.h"
#include "memory.h"
#include "snes.h"
#include "fpga.h"
#include "fpga_spi.h"
#include "cic.h"
#include "xmodem.h"
#include "rtc.h"

#include "cli.h"

#define MAX_LINE 250

/* Variables */
static char cmdbuffer[MAX_LINE+1];
static char *curchar;

/* Word lists */
static char command_words[] =
  "cd\0reset\0sreset\0dir\0ls\0test\0exit\0loadrom\0loadraw\0saveraw\0put\0rm\0mkdir\0d4\0vmode\0mapper\0settime\0time\0setfeature\0hexdump\0w8\0w16\0memset\0cheat\0fpgaconf\0dspfeat\0bsregs\0gameloop\0dacboost\0";
enum { CMD_CD = 0, CMD_RESET, CMD_SRESET, CMD_DIR, CMD_LS, CMD_TEST, CMD_EXIT, CMD_LOADROM, CMD_LOADRAW, CMD_SAVERAW, CMD_PUT, CMD_RM, CMD_MKDIR, CMD_D4, CMD_VMODE, CMD_MAPPER, CMD_SETTIME, CMD_TIME, CMD_SETFEATURE, CMD_HEXDUMP, CMD_W8, CMD_W16, CMD_MEMSET, CMD_CHEAT, CMD_FPGACONF, CMD_DSPFEAT, CMD_BSREGS, CMD_GAMELOOP, CMD_DACBOOST };

/* ------------------------------------------------------------------------- */
/*   Parse functions                                                         */
/* ------------------------------------------------------------------------- */

/* Skip spaces at curchar */
static uint8_t skip_spaces(void) {
  uint8_t res = (*curchar == ' ' || *curchar == 0);

  while (*curchar == ' ')
    curchar++;

  return res;
}

/* Parse the string in curchar for an integer with bounds [lower,upper] */
static int32_t parse_unsigned(uint32_t lower, uint32_t upper, uint8_t base) {
  char *end;
  uint32_t result;

  if (strlen(curchar) == 1 && *curchar == '?') {
    printf("Number between %ld[0x%lx] and %ld[0x%lx] expected\n",lower,lower,upper,upper);
    return -2;
  }

  errno = 0;
  result = strtoul(curchar, &end, base);
  if ((*end != ' ' && *end != 0) || errno != 0) {
    printf("Invalid numeric argument\n");
    return -1;
  }

  curchar = end;
  skip_spaces();

  if (result < lower || result > upper) {
    printf("Numeric argument out of range (%ld..%ld)\n",lower,upper);
    return -1;
  }

  return result;
}
/* Parse the string starting with curchar for a word in wordlist */
static int8_t parse_wordlist(char *wordlist) {
  uint8_t i, matched;
  char *cur, *ptr;
  char c;

  i = 0;
  ptr = wordlist;

  // Command list on "?"
  if (strlen(curchar) == 1 && *curchar == '?') {
    printf("Commands available: \n ");
    while (1) {
      c = *ptr++;
      if (c == 0) {
        if (*ptr == 0) {
          printf("\n");
          return -2;
        } else {
          printf("\n ");
        }
      } else
        uart_putc(c);
    }
  }

  while (1) {
    cur = curchar;
    matched = 1;
    c = *ptr;
    do {
      // If current word list character is \0: No match found
      if (c == 0) {
        printf("Unknown word: %s\n(use ? for help)",curchar);
        return -1;
      }

      if (tolower((int)c) != tolower((int)*cur)) {
        // Check for end-of-word
        if (cur != curchar && (*cur == ' ' || *cur == 0)) {
          // Partial match found, return that
          break;
        } else {
          matched = 0;
          break;
        }
      }
      ptr++;
      cur++;
      c = *ptr;
    } while (c != 0);

    if (matched) {
      char *tmp = curchar;

      curchar = cur;
      // Return match only if whitespace or end-of-string follows
      // (avoids mismatching partial words)
      if (skip_spaces()) {
        return i;
      } else {
        printf("Unknown word: %s\n(use ? for help)\n",tmp);
        return -1;
      }
    } else {
      // Try next word in list
      i++;
      while (*ptr++ != 0) ;
    }
  }
}

/* Read a line from serial, uses cmdbuffer as storage */
static char *getline(char *prompt) {
  int i=0;
  char c;

  printf("\n%s",prompt);
  memset(cmdbuffer,0,sizeof(cmdbuffer));

  while (1) {
    c = uart_getc();
    if (c == 13)
      break;

    if (c == 27 || c == 3) {
      printf("\\\n%s",prompt);
      i = 0;
      memset(cmdbuffer,0,sizeof(cmdbuffer));
      continue;
    }

    if (c == 127 || c == 8) {
      if (i > 0) {
        i--;
        uart_putc(8);   // backspace
        uart_putc(' '); // erase character
        uart_putc(8);   // backspace
      } else
        continue;
    } else {
      if (i < sizeof(cmdbuffer)-1) {
        cmdbuffer[i++] = c;
        uart_putc(c);
      }
    }
  }
  cmdbuffer[i] = 0;
  return cmdbuffer;
}


/* ------------------------------------------------------------------------- */
/*   Command functions                                                       */
/* ------------------------------------------------------------------------- */

/* Reset */
static void cmd_reset(void) {
  /* force watchdog reset */
  LPC_WDT->WDTC = 256; // minimal timeout
  LPC_WDT->WDCLKSEL = BV(31); // internal RC, lock register
  LPC_WDT->WDMOD = BV(0) | BV(1); // enable watchdog and reset-by-watchdog
  LPC_WDT->WDFEED = 0xaa;
  LPC_WDT->WDFEED = 0x55; // initial feed to really enable WDT
}

/* Show the contents of the current directory */
static void cmd_show_directory(void) {
  FRESULT res;
  DIR dh;
  FILINFO finfo;
  uint8_t *name;
  uint8_t buf[256];
  f_getcwd((TCHAR*)buf, 255);

  res = f_opendir(&dh, (TCHAR*)buf);
  if (res != FR_OK) {
    printf("f_opendir failed, result %d\n",res);
    return;
  }

  finfo.lfname = (TCHAR*)buf;
  finfo.lfsize = 255;

  do {
    /* Read the next entry */
    res = f_readdir(&dh, &finfo);
    if (res != FR_OK) {
      printf("f_readdir failed, result %d\n",res);
      return;
    }

    /* Abort if none was found */
    if (!finfo.fname[0])
      break;

    /* Skip volume labels */
    if (finfo.fattrib & AM_VOL)
      continue;

    /* Select between LFN and 8.3 name */
    if (finfo.lfname[0])
      name = (uint8_t*)finfo.lfname;
    else {
      name = (uint8_t*)finfo.fname;
      strlwr((char *)name);
    }

    printf("%s [%s] (%ld)",finfo.lfname, finfo.fname, finfo.fsize);

    /* Directory indicator (Unix-style) */
    if (finfo.fattrib & AM_DIR)
      uart_putc('/');

    printf("\n");
  } while (finfo.fname[0]);
}

static void cmd_loadrom(void) {
  uint32_t address = 0;
  uint8_t flags = LOADROM_WITH_SRAM | LOADROM_WITH_RESET;
  strncpy((char*)file_lfn, (const char*)curchar, 255);
  load_rom((uint8_t*)curchar, address, flags);
}

static void cmd_loadraw(void) {
  uint32_t address = parse_unsigned(0,16777216,16);
  load_sram((uint8_t*)curchar, address);
}

static void cmd_saveraw(void) {
  uint32_t address = parse_unsigned(0,16777216,16);
  uint32_t length = parse_unsigned(0,16777216,16);
  if(address != -1 && length != -1)
    save_sram((uint8_t*)curchar, length, address);
}

static void cmd_d4(void) {
  int32_t hz;

  if(get_cic_state() != CIC_PAIR) {
    printf("not in pair mode\n");
  } else {
    hz = parse_unsigned(50,60,10);
    if(hz==50) {
      cic_d4(CIC_PAL);
    } else {
      cic_d4(CIC_NTSC);
    }
    printf("ok\n");
  }
}

static void cmd_vmode(void) {
  int32_t hz;
  if(get_cic_state() != CIC_PAIR) {
    printf("not in pair mode\n");
  } else {
    hz = parse_unsigned(50,60,10);
    if(hz==50) {
      cic_videomode(CIC_PAL);
    } else {
      cic_videomode(CIC_NTSC);
    }
    printf("ok\n");
  }
}

void cmd_put(void) {
  if(*curchar != 0) {
    file_open((uint8_t*)curchar, FA_CREATE_ALWAYS | FA_WRITE);
    if(file_res) {
      printf("FAIL: error opening file %s\n", curchar);
    } else {
      printf("OK, start xmodem transfer now.\n");
      xmodem_rxfile(&file_handle);
    }
    file_close();
  } else {
    printf("Usage: put <filename>\n");
  }
}

void cmd_rm(void) {
  FRESULT res = f_unlink(curchar);
  if(res) printf("Error %d removing %s\n", res, curchar);
}

void cmd_mkdir(void) {
  FRESULT res = f_mkdir(curchar);
  if(res) printf("Error %d creating directory %s\n", res, curchar);
}

void cmd_mapper(void) {
  int32_t mapper;
  mapper = parse_unsigned(0,7,10);
  set_mapper((uint8_t)mapper & 0x7);
  printf("mapper set to %ld\n", mapper);
}

void cmd_sreset(void) {
  if(*curchar != 0) {
    int32_t resetstate;
    resetstate = parse_unsigned(0,1,10);
    snes_reset(resetstate);
  } else {
    snes_reset_pulse();
  }
}
void cmd_settime(void) {
  struct tm time;
  if(strlen(curchar) != 4+2+2 + 2+2+2) {
    printf("invalid time format (need YYYYMMDDhhmmss)\n");
  } else {
    time.tm_sec = atoi(curchar+4+2+2+2+2);
    curchar[4+2+2+2+2] = 0;
    time.tm_min = atoi(curchar+4+2+2+2);
    curchar[4+2+2+2] = 0;
    time.tm_hour = atoi(curchar+4+2+2);
    curchar[4+2+2] = 0;
    time.tm_mday = atoi(curchar+4+2);
    curchar[4+2] = 0;
    time.tm_mon = atoi(curchar+4);
    curchar[4] = 0;
    time.tm_year = atoi(curchar);
    set_rtc(&time);
  }
}

void cmd_time(void) {
  struct tm time;
  read_rtc(&time);
  printf("%04d-%02d-%02d %02d:%02d:%02d\n", time.tm_year, time.tm_mon,
    time.tm_mday, time.tm_hour, time.tm_min, time.tm_sec);
}

void cmd_setfeature(void) {
  uint16_t feat = parse_unsigned(0, 65535, 16);
  fpga_set_features(feat);
}

void cmd_hexdump(void) {
  uint32_t offset = parse_unsigned(0, 16777215, 16);
  uint32_t len = parse_unsigned(0, 16777216, 16);
  sram_hexdump(offset, len);
}

void cmd_w8(void) {
  uint32_t offset = parse_unsigned(0, 16777215, 16);
  uint8_t val = parse_unsigned(0, 255, 16);
  sram_writebyte(val, offset);
}

void cmd_w16(void) {
  uint32_t offset = parse_unsigned(0, 16777215, 16);
  uint16_t val = parse_unsigned(0, 65535, 16);
  sram_writeshort(val, offset);
}

void cmd_memset(void) {
  uint32_t offset = parse_unsigned(0, 16777215, 16);
  uint32_t len = parse_unsigned(0, 16777216, 16);
  uint8_t val = parse_unsigned(0, 255, 16);
  sram_memset(offset, len, val);
}

void cmd_cheat(void) {
  int8_t index = parse_unsigned(0, 7, 10);
  uint32_t code = parse_unsigned(0, 0xffffffff, 16);
  fpga_write_cheat(index, code);
}

void cmd_test(void) {
  int i;
  uint8_t databuf[512];
  fpga_set_snescmd_addr(0);
  for(i=0; i<512; i++) {
    databuf[i]=fpga_read_snescmd();
  }
  uart_trace(databuf, 0, 512);
}

void cmd_fpgaconf(void) {
  if(!strncmp(curchar, "ROM", 3)) {
    fpga_rompgm();
    set_rom_mask(0x3fffff);
  } else {
    fpga_pgm((uint8_t*)curchar);
  }
}

void cmd_dspfeat(void) {
  int32_t feat = parse_unsigned(0, 0xffff, 16);
  if(feat != -1) fpga_set_dspfeat((uint16_t) feat);
}

void cmd_bsregs(void) {
  uint8_t set = parse_unsigned(0, 0xff, 16);
  uint8_t reset = parse_unsigned(0, 0xff, 16);
  set_bsx_regs(set, reset);
}

static void cmd_gameloop(void) {
  snes_set_mcu_cmd(SNES_CMD_GAMELOOP);
}

static void cmd_dacboost(void) {
  int8_t boost = parse_unsigned(0, 255, 16);
  if(boost != -1) fpga_set_dac_boost(boost);
}

static void cmd_cd(void) {
#if _FS_RPATH
  FRESULT res;
  uint8_t buf[256];
  if (strlen(curchar) == 0) {
    f_getcwd((TCHAR*)buf, 255);
    printf("%s\n", buf);
  } else {
    res = f_chdir((const TCHAR *)curchar);
    if (res != FR_OK) {
      printf("chdir %s failed with result %d\n",curchar,res);
    } else {
      printf("Ok.\n");
    }
  }
#else
  printf("cd not supported.\n");
#endif
}

/* ------------------------------------------------------------------------- */
/*   CLI interface functions                                                 */
/* ------------------------------------------------------------------------- */

void cli_init(void) {
}

void cli_entrycheck() {
  if(uart_gotc() && uart_getc() == 27) {
    printf("*** BREAK\n");
    cli_loop();
  }
}

void cli_loop(void) {
  while (1) {
    curchar = getline(">");
    printf("\n");

    /* Remove whitespace */
    while (*curchar == ' ') curchar++;
    while (strlen(curchar) > 0 && curchar[strlen(curchar)-1] == ' ')
      curchar[strlen(curchar)-1] = 0;

    /* Ignore empty lines */
    if (strlen(curchar) == 0)
      continue;

    /* Parse command */
    int8_t command = parse_wordlist(command_words);
    if (command < 0)
      continue;

    switch (command) {
      case CMD_CD:
        cmd_cd();
        break;

      case CMD_RESET:
        cmd_reset();
        break;

      case CMD_SRESET:
        cmd_sreset();
        break;

      case CMD_DIR:
      case CMD_LS:
        cmd_show_directory();
        break;

      case CMD_EXIT:
        return;
        break;

      case CMD_LOADROM:
        cmd_loadrom();
        break;

      case CMD_LOADRAW:
        cmd_loadraw();
        break;

      case CMD_SAVERAW:
        cmd_saveraw();
        break;

      case CMD_RM:
        cmd_rm();
        break;

      case CMD_MKDIR:
        cmd_mkdir();
        break;

      case CMD_D4:
        cmd_d4();
        break;

      case CMD_VMODE:
        cmd_vmode();
        break;

      case CMD_PUT:
        cmd_put();
        break;

      case CMD_MAPPER:
        cmd_mapper();
        break;

      case CMD_SETTIME:
        cmd_settime();
        break;

      case CMD_TIME:
        cmd_time();
        break;

      case CMD_TEST:
        cmd_test();
        break;

      case CMD_SETFEATURE:
        cmd_setfeature();
        break;

      case CMD_HEXDUMP:
        cmd_hexdump();
        break;

      case CMD_W8:
        cmd_w8();
        break;

      case CMD_W16:
        cmd_w16();
        break;

      case CMD_MEMSET:
        cmd_memset();
        break;

      case CMD_CHEAT:
        cmd_cheat();
        break;

      case CMD_FPGACONF:
        cmd_fpgaconf();
        break;

      case CMD_DSPFEAT:
        cmd_dspfeat();
        break;

      case CMD_BSREGS:
        cmd_bsregs();
        break;

      case CMD_GAMELOOP:
        cmd_gameloop();
        break;

      case CMD_DACBOOST:
        cmd_dacboost();
        break;
    }
  }
}
