magnotrans/sd2snes/verilog/sd2snes_sdd1/Input_Manager.vhd

----------------------------------------------------------------------------------
-- Company: Traducciones Magno
-- Engineer: Magno
-- 
-- Create Date: 18.03.2018 18:59:09
-- Design Name: 
-- Module Name: Input_Manager - Behavioral
-- Project Name: 
-- Target Devices: 
-- Tool Versions: 
-- Description: 
-- 
-- Dependencies: 
-- 
-- Revision:
-- Revision 0.01 - File Created
-- Additional Comments:
-- 
----------------------------------------------------------------------------------


library IEEE;
use IEEE.STD_LOGIC_1164.ALL;
use IEEE.STD_LOGIC_ARITH.ALL;
use IEEE.STD_LOGIC_UNSIGNED.ALL;

-- Uncomment the following library declaration if using
-- arithmetic functions with Signed or Unsigned values
use IEEE.NUMERIC_STD.ALL;

-- Uncomment the following library declaration if instantiating
-- any Xilinx leaf cells in this code.
--library UNISIM;
--use UNISIM.VComponents.all;

entity Input_Manager is
	Port(	clk 									: in 	STD_LOGIC;
			-- control data
			DMA_Conf_Valid						: in	STD_LOGIC;
			DMA_In_Progress					: in	STD_LOGIC;
			Header_Valid						: out	STD_LOGIC;
			Header_BPP							: out	STD_LOGIC_VECTOR(1 downto 0);
			Header_Context						: out	STD_LOGIC_VECTOR(1 downto 0);
    		-- data input from ROM
			ROM_Data_tready 					: out STD_LOGIC;
			ROM_Data_tvalid					: in 	STD_LOGIC;
			ROM_Data_tdata						: in 	STD_LOGIC_VECTOR(15 downto 0);
			ROM_Data_tkeep						: in 	STD_LOGIC_VECTOR(1 downto 0);
			-- Golomb decoded value
			Decoded_Bit_tready				: in 	STD_LOGIC;
			Decoded_Bit_tuser					: in 	STD_LOGIC_VECTOR(7 downto 0);
			Decoded_Bit_tvalid				: out STD_LOGIC;
			Decoded_Bit_tdata					: out STD_LOGIC;
			Decoded_Bit_tlast					: out STD_LOGIC;
			-- DEBUG;
			ROM_CE								: in	STD_LOGIC;
			ROM_ADDR								: in	STD_LOGIC_VECTOR(21 downto 0);
			ROM_DATA								: in	STD_LOGIC_VECTOR(15 downto 0)	);
end Input_Manager;


architecture Behavioral of Input_Manager is
	


	COMPONENT FIFO_W2B
		GENERIC( FIFO_DEPTH					: integer;
					PROG_FULL_TH				: integer);
		PORT(	clk								: IN 	STD_LOGIC;
    			srst 								: IN 	STD_LOGIC;
    			wr_en								: IN 	STD_LOGIC;
    			din 								: IN 	STD_LOGIC_VECTOR(15 DOWNTO 0);
    			din_strb							: IN	STD_LOGIC_VECTOR(1 downto 0);
    			rd_en								: IN 	STD_LOGIC;
    			valid								: OUT STD_LOGIC;
    			dout								: OUT STD_LOGIC_VECTOR(7 DOWNTO 0);
    			full								: OUT STD_LOGIC;
    			empty								: OUT STD_LOGIC;				
    			prog_full						: OUT STD_LOGIC );
	END COMPONENT;
	
	COMPONENT Serializer
		Port(	clk									: IN 	STD_LOGIC;
				Rst									: IN	STD_LOGIC;
				FIFO_tready							: OUT	STD_LOGIC;
	   		FIFO_tvalid							: IN 	STD_LOGIC;
	   		FIFO_tdata							: IN 	STD_LOGIC_VECTOR(7 DOWNTO 0);
	    		Shift									: IN 	STD_LOGIC;
	    		Shift_cnt							: IN	STD_LOGIC_VECTOR(2 downto 0);
	    		Serial_tvalid						: OUT	STD_LOGIC;
	    		Serial_tdata						: OUT STD_LOGIC_VECTOR(7 downto 0) );
	END COMPONENT;
	 
	COMPONENT Golomb_N_Decoder
		Generic( N									: integer);
		Port(	clk									: IN 	STD_LOGIC;
				rst									: IN	STD_LOGIC;
	   		din_tready							: OUT	STD_LOGIC;
	   		din_tdata							: IN 	STD_LOGIC_VECTOR(N DOWNTO 0);
	   		din_tuser							: OUT	STD_LOGIC_VECTOR(2 downto 0);
	    		dout_tready							: IN 	STD_LOGIC;
	    		dout_tdata							: OUT STD_LOGIC;
	    		dout_tlast							: OUT STD_LOGIC);
	END COMPONENT;
	
	COMPONENT Golomb_0_Decoder
		Port(	clk									: IN 	STD_LOGIC;
				rst									: IN	STD_LOGIC;
	   		din_tready							: OUT	STD_LOGIC;
	   		din_tdata							: IN 	STD_LOGIC_VECTOR(0 DOWNTO 0);
	   		din_tuser							: OUT	STD_LOGIC_VECTOR(2 downto 0);
	    		dout_tready							: IN 	STD_LOGIC;
	    		dout_tdata							: OUT STD_LOGIC;
	    		dout_tlast							: OUT STD_LOGIC);
	END COMPONENT;

	type TipoEstado							is( WAIT_START, FILL_SERIALIZER, GET_HEADER, INIT_GOLOMB, WAIT_END);
	signal estado								: TipoEstado := WAIT_START;
	
	signal Decoded_Bit_tvalid_i			: STD_LOGIC := '0';
	signal Decoded_Bit_tlast_i				: STD_LOGIC := '0';
	signal Decoded_Bit_tdata_i				: STD_LOGIC := '0';
	signal Decoded_Bit_tuser_i				: STD_LOGIC_VECTOR(2 downto 0) := "000";

	signal FIFO_wr								: STD_LOGIC := '0';
	signal FIFO_rd								: STD_LOGIC := '0';
	signal FIFO_Full							: STD_LOGIC := '1';
	signal FIFO_valid							: STD_LOGIC := '0';
	signal FIFO_Data							: STD_LOGIC_VECTOR(7 downto 0) := (others => '0');

	signal Bit_Shift_Rdy						: STD_LOGIC := '0';
	signal Bit_Shift_Cnt						: STD_LOGIC_VECTOR(2 downto 0) := "000";
	signal Bit_Serializer_tvalid			: STD_LOGIC := '0';
	signal Bit_Serializer_tdata			: STD_LOGIC_VECTOR(7 downto 0) := (others => '0');
	
	signal G0_Run_End							: STD_LOGIC := '0';
	signal G1_Run_End							: STD_LOGIC := '0';
	signal G2_Run_End							: STD_LOGIC := '0';
	signal G3_Run_End							: STD_LOGIC := '0';
	signal G4_Run_End							: STD_LOGIC := '0';
	signal G5_Run_End							: STD_LOGIC := '0';
	signal G6_Run_End							: STD_LOGIC := '0';
	signal G7_Run_End							: STD_LOGIC := '0';
	signal G0_din								: STD_LOGIC_VECTOR(0 downto 0) := (others => '0');
	signal G1_din								: STD_LOGIC_VECTOR(1 downto 0) := (others => '0');
	signal G2_din								: STD_LOGIC_VECTOR(2 downto 0) := (others => '0');
	signal G3_din								: STD_LOGIC_VECTOR(3 downto 0) := (others => '0');
	signal G4_din								: STD_LOGIC_VECTOR(4 downto 0) := (others => '0');
	signal G5_din								: STD_LOGIC_VECTOR(5 downto 0) := (others => '0');
	signal G6_din								: STD_LOGIC_VECTOR(6 downto 0) := (others => '0');
	signal G7_din								: STD_LOGIC_VECTOR(7 downto 0) := (others => '0');
	signal G0_shift							: STD_LOGIC_VECTOR(2 downto 0) := (others => '0');
	signal G1_shift							: STD_LOGIC_VECTOR(2 downto 0) := (others => '0');
	signal G2_shift							: STD_LOGIC_VECTOR(2 downto 0) := (others => '0');
	signal G3_shift							: STD_LOGIC_VECTOR(2 downto 0) := (others => '0');
	signal G4_shift							: STD_LOGIC_VECTOR(2 downto 0) := (others => '0');
	signal G5_shift							: STD_LOGIC_VECTOR(2 downto 0) := (others => '0');
	signal G6_shift							: STD_LOGIC_VECTOR(2 downto 0) := (others => '0');
	signal G7_shift							: STD_LOGIC_VECTOR(2 downto 0) := (others => '0');
	signal Decoded_G0_tready				: STD_LOGIC := '0';
	signal Decoded_G0_tdata					: STD_LOGIC := '0';
	signal Decoded_G0_tlast					: STD_LOGIC := '0';
	signal Decoded_G1_tready				: STD_LOGIC := '0';
	signal Decoded_G1_tdata					: STD_LOGIC := '0';
	signal Decoded_G1_tlast					: STD_LOGIC := '0';
	signal Decoded_G2_tready				: STD_LOGIC := '0';
	signal Decoded_G2_tdata					: STD_LOGIC := '0';
	signal Decoded_G2_tlast					: STD_LOGIC := '0';
	signal Decoded_G3_tready				: STD_LOGIC := '0';
	signal Decoded_G3_tdata					: STD_LOGIC := '0';
	signal Decoded_G3_tlast					: STD_LOGIC := '0';
	signal Decoded_G4_tready				: STD_LOGIC := '0';
	signal Decoded_G4_tdata					: STD_LOGIC := '0';
	signal Decoded_G4_tlast					: STD_LOGIC := '0';
	signal Decoded_G5_tready				: STD_LOGIC := '0';
	signal Decoded_G5_tdata					: STD_LOGIC := '0';
	signal Decoded_G5_tlast					: STD_LOGIC := '0';
	signal Decoded_G6_tready				: STD_LOGIC := '0';
	signal Decoded_G6_tdata					: STD_LOGIC := '0';
	signal Decoded_G6_tlast					: STD_LOGIC := '0';
	signal Decoded_G7_tready				: STD_LOGIC := '0';
	signal Decoded_G7_tdata					: STD_LOGIC := '0';
	signal Decoded_G7_tlast					: STD_LOGIC := '0';
		
	signal FSM_Reset							: STD_LOGIC := '1';
	signal FSM_Get_Header					: STD_LOGIC := '0';
	signal FSM_Load_Golomb					: STD_LOGIC := '0';



	signal Control_ILA						: STD_LOGIC_VECTOR(35 downto 0);
	signal DBG_Cnt									: STD_LOGIC_VECTOR(15 downto 0) := (others => '0');

	component SDD1_Scope_Data
  PORT (
    CONTROL : INOUT STD_LOGIC_VECTOR(35 DOWNTO 0);
    CLK : IN STD_LOGIC;
    TRIG0 : IN STD_LOGIC_VECTOR(0 TO 0);
    TRIG1 : IN STD_LOGIC_VECTOR(0 TO 0);
    TRIG2 : IN STD_LOGIC_VECTOR(0 TO 0);
    TRIG3 : IN STD_LOGIC_VECTOR(7 DOWNTO 0);
    TRIG4 : IN STD_LOGIC_VECTOR(0 TO 0);
    TRIG5 : IN STD_LOGIC_VECTOR(7 DOWNTO 0);
    TRIG6 : IN STD_LOGIC_VECTOR(0 TO 0);
    TRIG7 : IN STD_LOGIC_VECTOR(0 TO 0);
	 TRIG8 : IN STD_LOGIC_VECTOR(0 to 0)	 );
end component;

					
component SDD1_Scope_Ctrl
  PORT (
    CONTROL0 : INOUT STD_LOGIC_VECTOR(35 DOWNTO 0));
end component;
	


begin  
	-- module output tready
	ROM_Data_tready									<= NOT FIFO_Full;
	
	-- FIFO for input words from ROM, that converts to byte data; FIFO is kept mid-full with 4 words
	-- (64 bits); worst IO rate case is 8 output bits * 8 bits per G7 code = 64 bits = 8 byte
	FIFO_wr												<= ROM_Data_tvalid AND NOT FIFO_Full;
	Input_Data : FIFO_W2B
		--Generic map(32, 16)
		Generic map(10, 8)
		Port map(clk									=> clk,
    				srst 									=> FSM_Reset,
    				wr_en									=> FIFO_wr,
	    			din 									=> ROM_Data_tdata,
	    			din_strb								=> ROM_Data_tkeep,
	    			rd_en									=> FIFO_rd,
	    			valid									=> FIFO_valid,
	    			dout									=> FIFO_Data,
	    			prog_full							=> FIFO_Full );


	Process( clk )
	Begin
		if rising_edge( clk ) then
			if( FIFO_rd = '1' AND FIFO_valid = '1' ) then
				DBG_Cnt								<= DBG_Cnt + 1;
			end if;
		end if;
	End Process;

	
   -- convert input bytes to bitstream
	Bitstream : Serializer
   	Port map(clk									=> clk,
   				Rst									=> FSM_Reset,
   				FIFO_tready							=> FIFO_rd,
   	   		FIFO_tvalid							=> FIFO_valid,
   	   		FIFO_tdata							=> FIFO_Data,
   	    		Shift									=> Bit_Shift_Rdy,
   	    		Shift_cnt							=> Bit_Shift_Cnt,
   	    		Serial_tvalid						=> Bit_Serializer_tvalid,
   	    		Serial_tdata						=> Bit_Serializer_tdata );
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
