magnotrans/sd2snes/verilog/sd2snes_sdd1/Probability_Estimator.vhd

----------------------------------------------------------------------------------
-- Company: Traducciones Magno
-- Engineer: Magno
-- 
-- Create Date: 22.03.2018 18:59:09
-- Design Name: 
-- Module Name: Probability_Estimator - Behavioral
-- Project Name: 
-- Target Devices: 
-- Tool Versions: 
-- Description: 
-- 
-- Dependencies: 
-- 
-- Revision:
-- Revision 0.01 - File Created
-- Additional Comments:
-- 
----------------------------------------------------------------------------------


library IEEE;
use IEEE.STD_LOGIC_1164.ALL;
use IEEE.STD_LOGIC_ARITH.ALL;
use IEEE.STD_LOGIC_UNSIGNED.ALL;

-- Uncomment the following library declaration if using
-- arithmetic functions with Signed or Unsigned values
use IEEE.NUMERIC_STD.ALL;


-- Uncomment the following library declaration if instantiating
-- any Xilinx leaf cells in this code.
--library UNISIM;
--use UNISIM.VComponents.all;

entity Probability_Estimator is
	Port(	clk 									: in 	STD_LOGIC;
			-- control data
			DMA_In_Progress					: in	STD_LOGIC;
			Header_Valid						: in	STD_LOGIC;
			Header_Context						: in	STD_LOGIC_VECTOR(1 downto 0);
    		-- run data from input manager
			Decoded_Bit_tready 				: out STD_LOGIC;
			Decoded_Bit_tuser					: out STD_LOGIC_VECTOR(7 downto 0);
			Decoded_Bit_tvalid				: in 	STD_LOGIC;
			Decoded_Bit_tdata					: in 	STD_LOGIC;
			Decoded_Bit_tlast					: in 	STD_LOGIC;
			-- estimated bit value
			BPP_Bit_tready						: in 	STD_LOGIC;
			BPP_Bit_tuser						: in 	STD_LOGIC_VECTOR(9 downto 0);
			BPP_Bit_tvalid						: out	STD_LOGIC;
			BPP_Bit_tdata						: out STD_LOGIC);
end Probability_Estimator;


architecture Behavioral of Probability_Estimator is
	
	type TipoEstado							is( WAIT_START, WAIT_END);
	signal estado								: TipoEstado := WAIT_START;
	
	type RAM_Reg_Status						is array(0 to 31) of integer range 0 to 32;
	signal RAM_STAT							: RAM_Reg_Status := (others => 0);
	type RAM_Reg_MPS							is array(0 to 31) of STD_LOGIC;
	signal RAM_MPS								: RAM_Reg_MPS := (others => '0');							 
	
	signal Context_Type						: STD_LOGIC_VECTOR(1 downto 0) := "00";
	signal Context								: STD_LOGIC_VECTOR(4 downto 0) := "00000";
	signal Context_tuser						: STD_LOGIC_VECTOR(4 downto 0) := "00000";
	signal Curr_MPS							: STD_LOGIC := '0';
	signal Next_MPS							: STD_LOGIC := '0';
	signal Curr_State							: integer range 0 to 32 := 0;
	signal Next_State							: integer range 0 to 32 := 0;
	signal Decoded_Bit_tready_i			: STD_LOGIC := '0';
	signal Decoded_Bit_tready_reg			: STD_LOGIC := '0';
	signal Decoded_Bit_tdata_reg			: STD_LOGIC := '0';
	signal Decoded_Bit_tlast_reg			: STD_LOGIC := '0';

	signal FSM_Reset							: STD_LOGIC := '1';

begin  
	-- capture header data and IM data
	Process( clk )
	Begin
		if rising_edge( clk ) then
			if( Header_Valid = '1' ) then
				Context_Type							<= Header_Context;
			end if;

			if( FSM_Reset = '1' ) then
				Decoded_Bit_tready_i					<= '0';
				Decoded_Bit_tdata_reg				<= '0';
				Decoded_Bit_tlast_reg				<= '0';
				Decoded_Bit_tready_reg				<= '0';
			else			
				-- when context is registered, we ask a new bit to IM
				Decoded_Bit_tready_i					<= BPP_Bit_tready;
					
				-- IM pre-fecthes each bit, so the data is available in the next cycle
				if( Decoded_Bit_tvalid = '1' ) then
					Decoded_Bit_tdata_reg			<= Decoded_Bit_tdata;
					Decoded_Bit_tlast_reg			<= Decoded_Bit_tlast;
				end if;
				Decoded_Bit_tready_reg				<= Decoded_Bit_tvalid;
			end if;
		end if;
	End Process;
	

	-- output bit is ready 1 cycle after IM returns a Golomb decoded bit
	BPP_Bit_tvalid										<= Decoded_Bit_tready_reg;
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
