magnotrans/sd2snes/(commit log)

2018-08-11 Source code update from develop to
    [fpga.sch, lpc1754.cfg, mcu.sch, memory.sch, pwr_misc.sch, sd2snes.kicad_pcb, sd2snes.sch, snesslot.sch]
2018-09-07 S-DD1 + base (trick)
    "sd2snes_trick" is the same implementation than "sd2snes_sdd1" but it is
    intended to be used as base firmware. It implements S-DD1 core but it is
    always disabled. It loads ROMs and runs games perfectly, except for
    StarOcean.
    "sd2snes_sdd1" corrects BHE and BLE assertion so all accesses from S-DD1
    to PSRAM are 16bit wide.
    "main.v" simulation is successfull and we get decompressed graphics as
    output.
    [fpga.sch, mcu.sch, memory.sch, pwr_misc.sch, sd2snes.sch, snesslot.sch]
2018-09-10 Bugfix for Street Fighter Alpha 2
    Corrected potential bugs in SFA2:
    * S-DD1 register bank ($480X) can be now accessed from any LoROM bank
    * Several DMA channels for decompression can be setup all at once. So writes to enable DMA[7] and DMA[0] (such as $4800 = $81) are now allowed.
    Using this bitstream as base firmware works with normal games even with MSU-1 (such as Secret of Mana), but StarOcean goes to black screen while downloading sound driver to SPC700 -> ROM mapping from the S-DD1 side is working but SNES data bus is corrupted.
    [DCM_Scope.v, DMC_Test.v, SDD1.vhd, main.v]
2018-09-14 SRAM write fix + new mapper
    SRAM write access now is done correctly, using MAPPED_SNES_ADDR and SNES_DATA buses.
    New mapper for ExtLoROM: mapper_id = 4. Be sure firmware supports this new mapper.
    [DCM_Scope.v, Input_Manager.vhd, SDD1.vhd, SDD1_Core.vhd, SNES_Scope_Data.v, address.v]
2018-09-15 Restored glith-free circuit
    Glitch-free circuit for SNES_READ and SNES_WRITE has been restored to the original implementation ikari did, but registering the output to shorten the maximum combinational path.
    SNES_ADDR, SNES_PA and SNES_DATA_IN have been optimized removing the AND operation in order to use their registered state.
    [DCM_Scope.v, Input_Manager.vhd, SDD1.vhd, SDD1_Core.vhd, SDD1_Scope_Ctrl.v]
2018-09-18 First S-DD1 decompression succesful
    Enix logo is decompressed successfully, although next logos are corrupted. Have to check reset after decompression.
    Star Ocean still hungs when accessing audio driver.
    [DCM_Scope.v, FIFO_B2B.vhd, FIFO_W2B.vhd, Input_Manager.vhd, Output_Manager.vhd, Probability_Estimator.vhd, SDD1.vhd, SDD1_Core.vhd]
2018-09-26 S-DD1 registers enabled for read
    Added process to allow S-DD1 register read; now StarOcean audio driver works, game runs but some graphics are still corrupted.
    Graphic corruption is different each time SD2SNES boots.
2018-11-24 Added slots for bus cycles. Fixed PSRAM collision with MCU. Fixed decompression state clear. Fixed decompression loop to not require $4800 clear. Fixed DMA register snooping to always record writes i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
    There are still random crashes and glitches to work through.
    [Output_Manager.vhd, SDD1.vhd, address.v, main.v, smc.c]
2018-11-25 Fixed some (all?) of the graphics glitches. May have been caused by underflow during refresh. See the comments in the code for further details. Changed SDD1.vhd spaces to tabs in an attempt to comply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
    [SDD1.vhd, main.v]
2018-11-26 Fixed bug introduced in a prior checkin where SRAM data is read as open bus rather than from the ROM. Fixed more MCU read/write bugs. Removed ROMSEL in address compares in case it doesn't have full c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
    [SDD1.vhd, address.v, main.v]
