magnotrans/sd2snes/(notices)

Notices in the files:
src/cli.c:
This program is free software; you can redistribute it and/or modify
it under the terms of the GNU General Public License as published by
the Free Software Foundation; version 2 of the License only.
pcb/kicad/RevF/sd2snes.kicad_pcb:
©2009 - 2014 ikari_01
